Caracol42/Discrete-Circuits-Amplifier-Project/Documents/Proyectodocumentationv1/Proyectdocumentation.pdf

# Discrete Electronics Project: Class AB Audio Amplifier Design and Simulation Report

María Fernanda Morales Calderón, Ian José Álvarez Arrieta, Oscar Felipe Montejo Cordero, Bryan Alessandro Elizondo Fallas, Andrés Obregón López
School of Electronics Engineering Tecnológico de Costa Rica (TEC) Analog One

Abstract—This paper presents the design and simulation of a discrete-component Class AB audio amplifier developed by Analog One. The system combines signal conditioning, voltage amplification, and a power stage to drive an 8 Ω loudspeaker. The design uses commercial component values and considers signal quality, transistor bias, and heat dissipation. The main calculations establish a 20W output reference. In the recorded reference test, a 20 V peak input at 10 kHz produced 22.8W of average load power. Calculated requirements and simulation readings are presented in separate tables to support a clear assessment of the design.
Index Terms—Class AB, audio amplifier, discrete circuits, MOSFET, circuit simulation.
I. PROJECT DESCRIPTION

The project develops an audio amplifier that increases the level of an incoming audio signal and supplies the power needed by an 8 Ω loudspeaker. Developed by Analog One, the design aims to reproduce the signal at a useful output level while limiting distortion and power losses.
The amplifier contains three stages. The preamplifier conditions the incoming signal, the voltage amplifier increases its amplitude, and the power stage provides the current required by the loudspeaker. The Class AB output arrangement uses two complementary transistors that share the audio waveform. A small resting current helps smooth the transition between the positive and negative portions of the signal.
The design combines calculations, commercial component values, and circuit simulation. The evaluation considers output power, signal transfer, bias adjustment, and heat dissipation, together with the interaction between the stages.

II. BLOCK DIAGRAMS

A. Overall Amplifier

Figure 1 shows how the signal moves through the amplifier. Each stage has a specific role, from preparing the incoming signal to delivering power to the loudspeaker.

Preamplification
Signal
conditioning

Voltage
amplification

Class AB
power stage
Audio input | 20 V peak interface | 8 Ω loudspeaker

Figure 1. Main stages of the audio amplifier.

B. Preamplification Stage
Figure 2 shows the functional structure of the preamplification stage. The incoming signal passes through an ACcoupling network to remove any DC offset before reaching the discrete BJT amplifier. The single-ended Common-Emitter (CE) topology provides the necessary voltage amplification, while an unbypassed emitter resistor stabilizes the bias point and thermal drift. Finally, an output coupling network blocks the collector DC level, delivering a clean audio AC waveform centered at 0 V DC to the downstream mixing and power stages.

Audio Input
Coupling

BJT CE Voltage
amplification

Output DC
blocking
Audio Signal input | 2N2222 Active stage | 0 V DC interface

Figure 2. Functional blocks of the BJT preamplifier stage.

C. Voltage Amplification Stage
The voltage amplifier connects the preamplifier to the input of the power stage. Figure 3 follows the signal from left to right. Each IRF530 inverts the signal at its drain, so the two stages together preserve the input polarity near midband. The IRF9540 supplies current to the second stage.

Input coupling
C1

First gain
Q4

Second gain
Q1 with Q2

Output through C4

Figure 3. Signal path through the voltage amplification stage.

D. Class AB Power Stage
The Class AB arrangement was selected because it combines a smooth transition between the two portions of an audio signal with moderate resting power consumption. Its overlapping conduction helps reduce crossover distortion, which is particularly relevant when reproducing small changes in the waveform [1, sec. 7–2].
The selected circuit also provides the current needed by the loudspeaker while preserving the signal polarity and most of its voltage amplitude. These features make it suitable as the final stage of an amplifier whose preceding stages already provide the required voltage level [1, sec. 9–2].

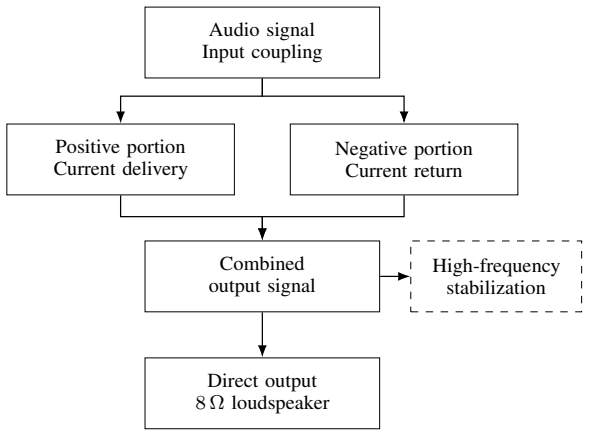
[picture p9: figure]
Audio signal Input coupling; Positive portion Current delivery; Negative portion Current return; Combined output signal; Direct output 8 Ω loudspeaker; High-frequency stabilization

Figure 4. Functional blocks of the selected Class AB output arrangement.

III. DESIGN CONSIDERATIONS AND CALCULATED VALUES

A. Preamplification Stage
The preamplifier uses a 2N2222 NPN BJT in a Common-Emitter (CE) configuration powered by a single positive supply VCC = 24 V (or +12 V single rail domain). Figure ?? presents the complete schematic diagram of the stage. The design uses an unbypassed emitter resistor R4 to fix the AC voltage gain independently of transistor parameter variations (β) and to minimize thermal drift.


Figure 5. Preamplifier schematic stage featuring 2N2222 BJT.

1) DC Operating Point Analysis: The DC bias network is established by the base voltage divider R1 and R2, collector resistor R3, and emitter resistor R4. Coupling capacitors C1 and C2 act as open circuits for DC.

The base Thévenin equivalent resistance RT h and voltage VT h are:

RT h = R1 ∥ R2 =

(68 kΩ)(33 kΩ)
68 kΩ + 33 kΩ

≈ 22.22 kΩ (1)

VT h = VCC (︃
R2
R1 + R2

)︃
= 24 V

(︃
33 kΩ
68 kΩ + 33 kΩ

)︃
≈ 7.84 V
| (2)
Assuming VBE = 0.7 V and a nominal current gain β = 150, the base bias current IBQ is:

IBQ =

VT h − VBE
RT h + (β + 1)R4

=

7.84 V − 0.7 V
22.22 kΩ + (151)(2.2 kΩ) ≈ 20.14 µA
| (3)
The quiescent collector current ICQ and emitter current IEQ are:
ICQ = βIBQ = (150)(20.14 µA) ≈ 3.02 mA | (4)
IEQ = (β + 1)IBQ ≈ 3.04 mA | (5)

The resulting DC voltages at the emitter (VE), collector (VC ), and collector-to-emitter (VCEQ) are calculated as:

VE = IEQR4 = (3.04 mA)(2.2 kΩ) ≈ 6.69 V (6)

VC = VCC −ICQR3 = 24 V−(3.02 mA)(4.7 kΩ) ≈ 9.81 V
| (7)
VCEQ = VC − VE = 9.81 V − 6.69 V = 3.12 V | (8)

The Q-point (VCEQ, ICQ) = (3.12 V, 3.02 mA) ensures stable operation within the linear active region.
2) Small-Signal AC Voltage Gain: The dynamic emitter resistance re at room temperature (VT ≈ 25.85 mV) is:

rre =

VT

ICQ

=

25.85 mV
3.02 mA
≈ 8.56 Ω | (9)

Because the emitter resistor R4 is fully unbypassed to control gain and prevent distortion/clipping, the small-signal voltage gain Av of the stage is given by:

Av =

vout

vin

≈ −

R3 ∥ RL
re + R4

≈ −

4.7 kΩ
8.56 Ω + 2.2 kΩ

≈ −2.13 V/V

| (10)
3) Thermal and Power Dissipation Analysis: At ambient temperature TA = 25◦C, the quiescent power dissipation of the transistor Q1 is:

PD,Q1 = VCEQICQ = (3.12 V)(3.02 mA) ≈ 9.42 mW
| (11)
Using the junction-to-ambient thermal resistance θJA = 200◦C/W for the TO-92 package, the operating junction temperature TJ is:

TJ = TA+PD,Q1θJA = 25◦C+(0.00942 W)(200◦C/W) ≈ 26.88◦C
| (12)
This negligible temperature rise (∆T ≈ 1.88◦C) confirms that
no external heat sink is required.

Table I
CALCULATED PREAMPLIFIER BIAS AND PERFORMANCE PARAMETERS
Parameter | Calculated Value
Base Voltage (VB) | 7.39 V
Emitter Voltage (VE) | 6.69 V
Collector Voltage (VC ) | 9.81 V
Quiescent Current (ICQ) | 3.02 mA
Collector-Emitter Voltage (VCEQ) | 3.12 V
Stage AC Voltage Gain (Av) | −2.13 V/V
Transistor Power Dissipation (PD,Q1) | 9.42 mW
Estimated Junction Temp. (TJ ) | 26.88◦C
B. Voltage Amplification Stage
Figure 6 shows the Multisim circuit used for the final test. The design target was a 20 V peak sine wave at the power-stage input from a 2 V RMS signal, using ±24 V supplies. The corresponding output voltage and required gain are

Vout,rms = 20/

√
2 = 14.14 V, | (13)
Av,target = 14.14/2 = 7.07 V/V. | (14)


Figure 6. Voltage amplification stage as tested in Multisim. VC4 is the common drain node before the output capacitor. The 43 kΩ resistor represents the load used for this stage test.

1) DC operating point: At zero input, C1 isolates the gate of Q4 from the source. Neglecting gate current, its bias divider gives
VG4 = 24 V 100
240 + 100
= 7.06 V, | (15)
RS4 = R5 + R6 = 2.09 kΩ. | (16)

Using the simulated Q4 drain level of 16.89 V and the 4.7 kΩ drain resistor, the first-stage bias can be reconstructed without assuming a fixed MOSFET threshold:

ID4 = (24 − 16.89) V/R1 = 1.51 mA, | (17)
VS4 = ID4RS4 = 3.16 V, | (18)
VGS4 = 7.06 − 3.16 = 3.90 V, | (19)
VDS4 = 16.89 − 3.16 = 13.73 V. | (20)

For Q2, the 1.0 kΩ and 5.3 kΩ divider sets the gate voltage to 24(5.3/6.3) = 20.19 V. In the second stage, R13 feeds the drain voltage back to the gate of Q1, and R9 returns the gate to −24 V. With the simulated resting voltage VX = −0.125 V at VC4, and negligible gate current, the DC path gives

Ifb = (VX + 24 V)/(R13 + R9) = 0.715 mA, | (21)
VG1 = −24 V + IfbR9 = −19.78 V. | (22)

This places the internal output close to the midpoint of the supplies. A 20 V excursion about that point leaves approximately 4 V to each rail, before allowing for voltage drops in the devices and source resistors.

2) Signal coupling and power: The input resistance set by the gate divider is R2 ∥ R4 = 70.6 kΩ. With the ideal test source, the input coupling corner is 1/(2πC1(R2 ∥ R4)) = 2.25 Hz. At the output, C4 blocks the internal DC level while R3 returns Vout to ground. At the target amplitude the load draws 14.14 V/43 kΩ = 0.329 mA RMS and dissipates 14.14²/43000 = 4.65 mW.

At rest, Q4 dissipates approximately VDS4ID4 = 20.8 mW. The Q2 gate divider draws 24 V/(6.3 kΩ) = 3.81 mA. Its resistor losses, calculated as I

2R, are 14.5 mW in R11 and 76.9 mW in R14.

For an estimate of the second-stage resting losses, take VGS1 ≈ 3.91 V, based on the observed gate-to-source voltage. Then VS1 ≈ −23.69 V and ID1 ≈ (VS1 + 24 V)/R8 = 3.07 mA. The active load supplies both this current and the feedback current, giving IQ2 ≈ 3.79 mA and VS2 ≈ 24 V − IQ2R10 = 23.62 V. Multiplying each drain-to-source voltage magnitude by its estimated current gives approximately 72 mW for Q1 and 90 mW for Q2. These are nominal bias estimates, distinct from the losses under signal drive.

C. Class AB Power Stage

Figure 7 presents the power-stage circuit. The design retains the complementary output arrangement, with nominal supplies of +24 V and −24 V. The load is connected directly to VOUT, the junction between RS1 and RS2.


Figure 7. Class AB power-stage schematic with IRFZ44N and IRF4905 MOSFETs.

1) Output Power Requirement: The design reference is 20W delivered to an 8 Ω load. For a sinusoidal signal, the average power is

PL =

V

2
L,rms
RL
. | (23)

Here, RMS is the effective voltage value used to calculate average audio power. The required load voltage and current are

VLOAD,rms =

√︁
(20)(8) ≈ 12.65 V, | (24)

VLOAD,peak =

√
2(12.65) ≈ 17.89 V, | (25)

ILOAD,rms =

12.65
8
≈ 1.58 A. | (26)

These values define the load requirements. With the specified 20 V peak input, the output power depends on the voltage transfer of the stage. Table II summarizes the calculated values.

Table II
CALCULATED OUTPUT REQUIREMENTS FOR THE 20W REFERENCE
Quantity | Calculated value
Average output power, reference | 20W
Load RMS voltage | 12.65 V
Load peak voltage | 17.89 V
Load peak-to-peak voltage | 35.78 V
Load RMS current | 1.58 A
Load peak current | 2.24 A
2) Class AB Bias Adjustment: Bias sets the transistor operating conditions before an audio signal is applied. The design adopts a quiescent drain-current target of IDQ = 50 mA in each branch. This small resting current provides the intended overlap between the two transistors near the signal transition [1, sec. 7–2].
The 0.22 Ω source resistors provide a convenient current reference. At the selected target, the drop across each resistor is
VRS,Q = IDQRS = (0.050)(0.22) = 11 mV. (27)

Bias adjustment targets these drops while keeping VOUT close to 0 V DC. Because SPK2 is connected directly to this node, the same DC voltage appears across the load.
The updated component labels give the effective bias resistances
RN = R2 + R1eff, | (28)
RP = R5 + R6eff. | (29)

The nominal gate voltages follow the two dividers:

VG,U1 = 24 V R3
RN + R3
, | (30)
VG,U2 = −24 V | R4
RP + R4
. | (31)

With R3 = R4 = 100 kΩ, the initial gate references of +3.6243 V and −3.6123 V correspond to RN = 562.2 kΩ and RP = 564.4 kΩ. Commercial 560 kΩ resistors R2 and R5 are combined with 10 kΩ trimmers R1 and R6. Their nominal effective settings are 2.2 kΩ and 4.4 kΩ, respectively, or 22% and 44% of the trimmer range.
These divider settings provide the initial gate voltages. The 50 mA target is assessed through the separate DC operatingpoint analysis and the drops in (27).

Table III
CALCULATED BIAS REFERENCES AND ADJUSTMENT TARGETS
Quantity | Design reference
U1 gate bias, initial | +3.6243 V
U2 gate bias, initial | −3.6123 V
RN = R2 + R1eff | 562.2 kΩ
RP = R5 + R6eff | 564.4 kΩ
R1 effective setting | 2.2 kΩ
R6 effective setting | 4.4 kΩ
IDQ, target per MOSFET | 50 mA
RS1 and RS2 drop at target | 11 mV each
VOUT at rest, target | 0 V DC
3) Signal Coupling: C1 and C2 transfer the audio signal to the gates while keeping their DC bias settings separate from the preceding stage. Each capacitor is 4.7 µF. With a lowimpedance driving source, the divider resistance seen by each capacitor is approximately 84.9 kΩ, giving an input coupling corner near 0.40 Hz. C1 and C2 are polarized electrolytics. With zero DC at VIN, the positive terminal of C1 faces the upper bias node, while the positive terminal of C2 faces VIN. The output is connected directly to the 8 Ω load. RZobel1 and C3 form the series output RC network, with values of 10 Ω and 100 nF. This branch provides a high-frequency load in parallel with the loudspeaker.

4) Heat Dissipation: All thermal calculations use an ambient temperature of TA = 25 ◦C, both at rest and during signal operation. The analysis relates each component’s power loss to its estimated steady-state temperature. Table IV summarizes the results and the thermal-resistance parameters used in the calculation.
Power losses: At IDQ = 50 mA, the resting losses in each MOSFET and source resistor are
PD,Q = (24 − IDQRS)IDQ ≃ 1.20W, | (32)
PRS,Q = I

2
DQRS = 0.55 mW. | (33)

Resistor losses follow PR = I

2
rmsR. For example, the recorded gate RMS voltage gives

PR3 = PR4 =

14.6

2
100000
= 2.13 mW. | (34)

The same calculation gives 1.09 mW in R2 and 1.08 mW in R5. R1 and R6 dissipate 4.28 µW and 8.50 µW, respectively. For the gate-resistor loss calculation, the estimated RMS currents are 1.306 mA and 3.022 mA:

PRG1 = (1.306 × 10⁻³
)

2
(100) ≃ 0.171 mW, (35)
PRG2 = (3.022 × 10⁻³
)

2
(100) ≃ 0.913 mW. | (36)
Capacitor losses follow PC | = I

2
C,rmsrESR, where ESR
represents the capacitor’s series loss resistance. Using a fixed ESR of 34 Ω and estimated currents of 1.317 mA and 3.026 mA gives

PC1 = (1.317 × 10⁻³
)

2
(34) ≃ 0.0590 mW, (37)
PC2 = (3.026 × 10⁻³
)

2
(34) ≃ 0.311 mW. (38)

These gate and input-capacitor currents are calculated with a constant input-capacitance approximation for the MOSFETs. At 10 kHz, the C3 loss calculation uses tan δ = 0.025:

XC3 =

1
2πfC3
= 159.15 Ω, | (39)
rESR,3 = tan δ XC3 = 3.98 Ω. | (40)

The Zobel-branch current is

IZ =

13.5
√︁
(10 + 3.98)² + 159.15²

≃ 84.50 mA. (41)

Therefore,

PRZobel1 = I

2
Z(10) ≃ 0.0714W, | (42)
PC3 = I

2
ZrESR,3 ≃ 0.0284W. | (43)

The source-resistor sizing calculation includes the load current, the Zobel-branch current, and IDQ:

PRS,design = 0.22(1.69 + 0.0845 + 0.050)² ≃ 0.732W. (44)

This power allowance applies to each 5W source resistor. Component temperatures: The passive-component temperature calculation is

Ti = TA + RθiPi

. | (45)

For example,

TRS1 = TRS2 ≃ 25 + (0.732)(55) = 65.3

◦C, | (46)

TC3 ≃ 25 + (0.0284)(1157) = 57.9

◦C. (47)

The same expression is applied to the remaining passive components using the power and thermal resistance listed in Table IV.
For the MOSFETs, the calculation includes a separate 4

◦C/W heat sink for each device and a 0.5

◦C/W mounting
interface:

TJ = TA + PD(RθJC + RθCS + RθSA). (48)

The datasheet junction-to-case thermal resistances are 1.5

◦C/W for U1 and 0.75 ◦C/W for U2 [2], [3]. Using the recorded transistor losses gives

TJ,U1 = 25 + 6.58(1.5 + 0.5 + 4) ≃ 64.5

◦C, (49)

TJ,U2 = 25 + 6.63(0.75 + 0.5 + 4) ≃ 59.8

◦C. (50)

At rest, the calculated junction temperatures are 32.2

◦C for U1
and 31.3

◦C for U2. At the 10W per-device design allowance, they are 85 ◦C and 77.5

◦C, below the selected 100 ◦C design limit.

Table IV
CALCULATED COMPONENT TEMPERATURES AT 25 ◦C
Component | Power used | Rθ (
| | ◦C/W) | Temperature (◦C)
U1 | 6.58W | 6.00 | 64.5
U2 | 6.63W | 5.25 | 59.8
R1 | 4.28 µW | 263 | 25.0
R2 | 1.09 mW | 140 | 25.2
R3, R4 | 2.13 mW each | 140 | 25.3 each
R5 | 1.08 mW | 140 | 25.2
R6 | 8.50 µW | 263 | 25.0
RG1 | 0.171 mW | 140 | 25.0
RG2 | 0.913 mW | 140 | 25.1
RS1, RS2 | 0.732W each | ≃ 55 | 65.3 each
RZobel1 | 0.0714W | 75 | 30.4
C1 | 0.0590 mW | 472 | 25.0
C2 | 0.311 mW | 472 | 25.1
C3 | 0.0284W | 1157 | 57.9

Temperatures are steady-state analytical estimates at 25 ◦C, rounded to 0.1

| | | ◦C. U1/U2
entries are junction temperatures; passive entries are body temperatures. The Rθ column lists the calculation parameters. RS1/RS2 use a power allowance for component sizing. Gate and capacitor losses are analytical estimates.

IV. COMPONENT SELECTION CRITERIA

A. Preamplification Stage
The selection of passive and active components for the preamplifier focuses on signal integrity, gain stability, and minimal noise introduction. Table V summarizes the chosen components and their design specifications.
- Transistor (Q1): The 2N2222 general-purpose NPN transistor was chosen due to its wide linear operational range, high gain-bandwidth product (fT > 250 MHz), and ready availability in TO-92 packages.
- Emitter Resistor (R4): Left unbypassed to introduce negative local feedback. This lowers non-linear distortion

Table V
PREAMPLIFIER COMPONENTS AND SELECTION RATINGS
Reference | Nominal Value | Selection Rating / Purpose
Q1 | 2N2222 | NPN BJT, general-purpose switching/amp
R1 | 68 kΩ | Metal film, 1%, 0.25 W (Upper Bias)
R2 | 33 kΩ | Metal film, 1%, 0.25 W (Lower Bias)
R3 | 4.7 kΩ | Metal film, 1%, 0.25 W (Collector Load)
R4 | 2.2 kΩ | Metal film, 1%, 0.25 W (Feedback Emitter)
R5 | 100 kΩ | Metal film, 1%, 0.25 W (Output Pull-down)
C1 | 470 nF | Film/Ceramic, 50 V (Input AC Coupling)
C2 | 2.2 µF | Electrolytic/Film, 50 V (Output DC Block)
C3 | 1 nF | Ceramic, 50 V (High-Freq Noise Filtering)

and prevents gain drift caused by temperature or β variations.
- Coupling Capacitors (C1, C2): Sized to maintain a lower cutoff corner frequency well below the audible spectrum (fL < 20 Hz), preventing baseline attenuation of lowfrequency audio content.
- Output Pull-down (R5): Provides a continuous reference to ground at the output side of C2, guaranteeing a zero DC baseline before entering the operational amplifier mixing stage.
B. Voltage Amplification Stage

Two IRF530 N-channel MOSFETs [4] were selected for voltage gain and an IRF9540 P-channel MOSFET [5] for the active load. Its maximum drain-to-source voltage is −100 V. Both models were available in the Multisim library and listed by the local supplier reviewed for the project. The source resistors provide local feedback. The values of the input and feedback resistors were tested together because they affect both the gain of Q1 and the load seen by Q4.

Table VI
VOLTAGE-STAGE COMPONENT VALUES USED IN THE FINAL SIMULATION.
Reference Value | Function
Q4, Q1 | IRF530 | Common-source gain
Q2 | IRF9540 | Active load
R2, R4 | 240, 100 kΩ | Q4 gate bias
R1 | 4.7 kΩ | Q4 drain load
R5, R6 | 1.27 kΩ, 820 Ω Q4 source path
R12, R13 | 3.48, 27.5 kΩ | Input and feedback
R9 | 5.9 kΩ | Return to −24 V
R8, R10 | 100 Ω each | Source resistors
R11, R14 | 1, 5.3 kΩ | Q2 gate bias
R3 | 43 kΩ | Output test load
C1 | 1 µF | Nonpolar input coupling
C3, C4 | 4.7 µF each | Interstage and output
C. Class AB Power Stage

The selected components retain the circuit topology and use commercial nominal values. Table VII lists the main components and the ratings considered in their selection.

Table VII
POWER-STAGE COMPONENTS AND SELECTION RATINGS
Reference | Value or model | Selection rating
U1 | IRFZ44N | N-channel MOSFET
U2 | IRF4905 | P-channel MOSFET
R2, R5 | 560 kΩ | 1%, 0.25W
R3, R4 | 100 kΩ | 1%, 0.25W
R1, R6 | 10 kΩ | Trimmers, 0.25W
RG1, RG2 | 100 Ω | 0.25W
RS1, RS2 | 0.22 Ω | 5W
C1, C2 | 4.7 µF | 50 V, electrolytic
RZobel1 | 10 Ω | 2W
C3 | 100 nF | 50 V, ceramic, code 104
SPK2 | 8 Ω | 30W nominal rating

The MOSFET voltage ratings are considered together with the ±24 V supplies and the expected signal excursions [2], [3]. The source-resistor power ratings provide margin for the load current, while the gate resistors and output RC network help control high-frequency behavior.
The heat-sink selection follows the stated dissipation allowance. The component references in Table VII match the updated schematic, including C1/C2 as electrolytic coupling capacitors and C3 as the 100 nF ceramic Zobel capacitor marked 104.
V. SIMULATION METHODOLOGY
A. Common Simulation Conditions
Multisim provides the circuit environment for the reported test. The power-stage input is a 20 V peak sinusoidal signal at 10 kHz, with zero DC offset. The circuit uses nominal ±24 V supplies and an 8 Ω load. R1 and R6 have nominal settings of 22% and 44%, respectively. These settings establish the initial divider voltages; the DC analysis assesses IDQ separately.
B. Preamplification Stage
The simulation of the BJT preamplifier stage was conducted in both LTspice and NI Multisim to verify DC biasing, dynamic transient behavior, and overall voltage amplification before physical assembly.
1) DC Operating Point Analysis: The simulation evaluates the circuit under zero-input signal condition (vin = 0 V AC). It measures the base voltage (VB), emitter voltage (VE), collector voltage (VC ), and collector bias current (ICQ) of transistor Q1. The objective is to verify that the operating point resides in the linear active region (VCEQ ≈ 3.12 V, ICQ ≈ 3.02 mA), avoiding saturation or cutoff limits and providing adequate headroom for signal swings.
2) Transient Analysis: A 1 kHz sinusoidal voltage source (V1) was applied at the input coupling capacitor C1. Transient simulations were run with a time step sufficient to capture multiple complete audio cycles (e.g., tstop = 10 ms). The transient response measures the peak-topeak input and output voltage waveforms, evaluating the stage voltage gain Av = vout/vin and checking for asymmetrical clipping or waveform distortion caused by high signal amplitudes.
3) Frequency Response and Filtering: An AC sweep simulation (10 Hz to 100 kHz) was executed to determine the lower and upper −3 dB cutoff frequencies (fL and fH). This analysis assesses the high-pass response determined by coupling capacitors C1 and C2, as well as the high-frequency attenuation introduced by filtering capacitor C3.
C. Voltage Amplification Stage
The voltage stage was tested separately in Multisim using the 43 kΩ load in Fig. 6. First, the source amplitude was set to zero and the voltage at VC4 was recorded. Next, a 2 V RMS, 1 kHz sine wave was applied. Cursors on the output trace measured the positive and negative peaks relative to ground.
The Fourier analysis used a 1 kHz fundamental, nine harmonics and a 2 s stop time to allow the coupling capacitors to settle. Distortion was calculated from harmonic amplitudes Vn measured using the same convention:

THD2:9 = 100

√︂∑︁9
n=2 V ²
n
V1
%. | (51)

Here V1 in the equation denotes the output fundamental. A separate small-signal AC sweep measured |Vout/Vin| with a unit AC input. Output amplitude and distortion were assessed from the driven sine-wave test.

D. Class AB Power Stage
1) DC Operating Point: The DC analysis examines the circuit with no audio input. It identifies the transistor bias and the internal output voltage. The design targets are IDQ = 50 mA in each branch, 11 mV across each source resistor, and VOUT close to zero. These references define the intended Class AB resting condition.
2) Transient Response: The transient analysis follows the input and output signals over time. It provides the voltage, current, and average-power measurements reported in the results. The method compares settled signal cycles, allowing the output level and the transition between the two transistors to be examined under the same test conditions.
3) Frequency Response and Signal Quality: Frequency-response evaluation examines how the amplifier handles signals at different audio frequencies. Waveform and harmonic analyses assess changes in signal shape, including the transition between the positive and negative portions. These assessments complement the power measurements; the numerical readings presented here correspond to the documented 10 kHz test.

VI. SIMULATED VALUES AND RESULTS

A. Preamplification Stage
The preamplifier stage was simulated in NI Multisim to evaluate both the DC bias point and the transient response under real audio signal excitation.
Table VIII compares the calculated theoretical DC parameters with the values obtained from the simulation. The results show close agreement, with maximum percentage deviations below 4.3%. The simulated collector current ICQ = 1.055 mA and collector voltage VC = 19.466 V confirm that the 2N2222 transistor operates within its linear active region with sufficient voltage swing headroom. Furthermore, the simulated DC voltage at the output node (Vout,DC = 194.66 pV) confirms the effectiveness of the output coupling network (C2) in isolating the DC bias from downstream stages.

Table VIII
COMPARISON OF CALCULATED AND SIMULATED DC OPERATING PARAMETERS
Parameter | Calculated | Simulated | Deviation (%)
Base Voltage (VB) | 3.07 V | 3.03 V | 1.30%
Emitter Voltage (VE) | 2.24 V | 2.33 V | 4.02%
Collector Voltage (VC ) | 19.65 V | 19.47 V | 0.92%
Collector Current (ICQ) | 1.012 mA | 1.055 mA | 4.25%
Collector-Emitter Voltage (VCEQ) | 17.41 V | 17.14 V | 1.55%
Output DC Baseline (Vout,DC ) | 0 V | 194.66 pV | ∼ 0%

Under dynamic excitation, the output audio signal exhibits symmetric voltage excursions reaching approximately 1 Vpp (±500 mVpeak) centered at 0 V DC, demonstrating clean linear amplification without clipping or crossover distortion.

Figure 8. Simulated transient audio output signal Vout showing symmetric AC swing centered at 0 V DC.

B. Voltage Amplification Stage
The final circuit delivered +19.919 V and −20.056 V at the output (Fig. 9). Their difference is 39.975 V peak to peak, within 0.07% of the 40 V peak-to-peak target. The resulting gain from the time-domain extrema is

Av =

39.975
2

√
2 (2)
= 7.07 V/V. | (52)

The fundamental corresponds to 20.112/

√
| 2 = 14.22 V
RMS. Its peak amplitude differs slightly from either oscilloscope cursor because the waveform also contains harmonics.
C. Class AB Power Stage

Tables X and XI retain the available 10 kHz reference readings for comparison and thermal calculations. The updated schematic defines a single output node shared by the source-resistor junction and SPK2. RMS describes the effective signal level, peak-to-peak describes the full voltage or current swing,


Figure 9. Multisim test at 2 V RMS and 1 kHz. Channel A (red) shows Vout. The cursors mark opposite peaks.

Table IX
FINAL VOLTAGE-STAGE RESULTS WITH THE 43 kΩ LOAD.
Quantity | Simulation result
Internal output at rest (VC4) | −0.125 V
Output DC, Fourier record | 0.996 mV
Output fundamental at 1 kHz | 20.112 V peak
Second / third harmonic | 0.077/0.193 V peak
THD through the ninth harmonic 1.183%
Small-signal gain near 20 Hz | 6.930 V/V
Small-signal gain near 1 kHz | 7.118 V/V

and mean describes the average DC component. The power readings are average values over the measurement interval.

Table X
RECORDED VOLTAGE REFERENCES AT 10 kHz
Location | Peak-to-peak RMS | Mean
IRFZ44N gate | 39.9 V | 14.6 V | +3.62 V
IRF4905 gate | 39.8 V | 14.6 V | −3.62 V
Output AC reference | 38.2 V | 13.5 V | —

The output reference is 13.5 V RMS. The dash indicates that a DC measurement for the revised VOUT connection is not included in these reference readings. Its DC adjustment target is 0 V. The gate means describe signal-on operation; IDQ is assessed with the input amplitude set to zero.

Table XI
RECORDED CURRENT AND POWER REFERENCES AT 10 kHz
Quantity | Simulated value
Load-current peak-to-peak | 4.78 A
Load-current RMS | 1.69 A
Average loudspeaker-load power | 22.8W
IRFZ44N average dissipation | 6.58W
IRF4905 average dissipation | 6.63W
Signal frequency | 10.0 kHz

The reference output-power reading exceeds the 20W design reference. The transistor dissipation values describe heat produced within the output devices and are accounted for separately from the power received by the load.

VII. ANALYSIS AND INTEGRATION

A. Preamplification Stage
The calculated small-signal gain Av ≈ −2.13 V/V provides moderate, highly controlled amplification without driving the output into saturation or cut-off under standard audio linelevel inputs. By setting the quiescent collector voltage VC to approximately 9.81 V, the collector node retains ample headroom for positive and negative voltage swings.
When integrated into the complete audio system, the preamplifier’s output node connects via C2 to the input resistor of the TL081-based summer/inverting stage (R11 = 2.2 kΩ). The output coupling network (C2 and R5) successfully eliminates the +9.81 V DC offset from the colector of Q1, ensuring the TL081 receiving terminal operates centered at 0 V DC. Furthermore, the unbypassed topology eliminates clipping at the peak excursions, matching the downstream headroom requirements of the Class AB output driver stage.
B. Voltage Amplification Stage

The resistor changes were evaluated at comparable output levels. At 1 kHz, one intermediate network produced 15.2 V RMS with 4.87% THD. A lower-resistance network produced 15.1 V RMS with 2.85% THD. In the final network, increasing R12 from 3.3 to 3.48 kΩ brought the measured swing from 40.80 to 39.98 V peak to peak and reduced THD from 1.37% to 1.18%. The final choice therefore reflects both the voltage required at the interface and the shape of the signal.
The standalone test establishes the voltage available to drive the next block. The 43 kΩ load draws a fraction of a milliampere, whereas the Class AB stage supplies the loudspeaker current. When the stages are connected, the input bias network of the power stage becomes an additional load. The corresponding interface check is to measure the voltage at the power-stage input under that load.
C. Class AB Power Stage

The recorded reference output voltage supports the average-power result. Applying (23) gives

PL =

(13.5)²
8
= 22.78W, | (53)

which agrees with the 22.8W simulation reading after rounding. The expected current is 13.5/8 = 1.69 A RMS, also consistent with the recorded value.
The 38.2 V peak-to-peak output corresponds to approximately 19.1 V peak. Compared with the specified 20 V peak input, the output amplitude is 95.5% of the input amplitude. This small reduction is consistent with the power stage’s role of supplying current while preserving the signal polarity and most of its voltage amplitude.
In the recorded reference test, the delivered power is 14% above the 20W objective. This result provides the comparison baseline for the updated power-stage schematic. The two transistor losses are similar, and both remain below the 10W per-device thermal design allowance.
For integration with the complete amplifier, the preceding stage provides the required input amplitude while driving the power-stage input. The bias references describe the resting condition, while the reported voltage, current, and power values describe operation with the audio test signal applied.

VIII. CONCLUSIONS AND NEXT STEPS

A. Preamplification Stage
The discrete 2N2222 BJT preamplifier stage was successfully designed and mathematically verified. By employing an unbypassed emitter topology, the stage achieves stable AC voltage gain while preserving signal linearity and preventing clipping. The DC bias point (VCEQ = 3.12 V, ICQ = 3.02 mA) ensures linear active operation, with a negligible thermal dissipation of 9.42 mW that keeps operating temperatures near 26.88◦C. Next Steps:
- Perform transient sweep simulations in LTspice/Multisim to confirm dynamic AC parameters, frequency response, and Total Harmonic Distortion (THD).
- Verify experimental integration with the TL081 mixing stage to adjust overall systemic gains.
- Validate physical breadboard performance against calculated bias points.
B. Voltage Amplification Stage
At 1 kHz the simulated voltage stage converted a 2 V RMS input into a 39.975 V peak-to-peak output across 43 kΩ. The two measured peaks were within 0.1 V of the nominal ±20 V interface level, with 1.18% THD. For the prototype, the first checks are the resting voltage at VC4 and the output swing with the power-stage input connected. Comparing those readings with the standalone results will show the effects of loading and device variation.
C. Class AB Power Stage
The complementary IRFZ44N/IRF4905 stage retains the Class AB topology and uses commercial component values. Its bias design includes a IDQ = 50 mA resting-current target, with trimmers for adjustment and source resistors that provide current references. C1 and C2 couple the input signal to the transistor gates, while the load connects directly to VOUT. The thermal assessment covers transistor, resistor, and capacitor losses and gives calculated temperature estimates for the stage electronics.
With a 20 V peak input at 10 kHz, the recorded reference test delivered 22.8W to an 8 Ω load, exceeding the 20W design reference. The output reaches 13.5 V RMS and 1.69 A RMS. These reference results support the power-delivery objective for the documented test. The updated DC assessment uses the direct output connection and the 50 mA adjustment target. The thermal calculation gives MOSFET junction temperatures of 64.5

◦C and 59.8

◦C. Frequency-response, signal-quality, and connected-stage assessments complete the evaluation framework for the amplifier.

REFERENCES

[1] T. L. Floyd, Dispositivos electrónicos, 8th ed. Mexico: Pearson Educación, 2008, secs. 7–2 and 9–2.
[2] International Rectifier, “IRFZ44NPbF: HEXFET power MOSFET,” datasheet, document PD-94787B, pp. 1–4.
[3] Infineon Technologies, “IRF4905PbF: HEXFET power MOSFET,” datasheet, rev. 2.1, Apr. 8, 2026, pp. 1–4.
[4] ON Semiconductor, “IRF530: TMOS E-FET Power Field Effect Transistor,” datasheet, publication IRF530/D, rev. 2, Aug. 2006.
[5] Vishay Siliconix, “IRF9540 Power MOSFET,” datasheet, document 91078, rev. C, Aug. 16, 2021. https://www.vishay.com/docs/91078/91078.pdf.
