Caracol42/Discrete-Circuits-Amplifier-Project/Documents/fig/pot20w(3).pdf

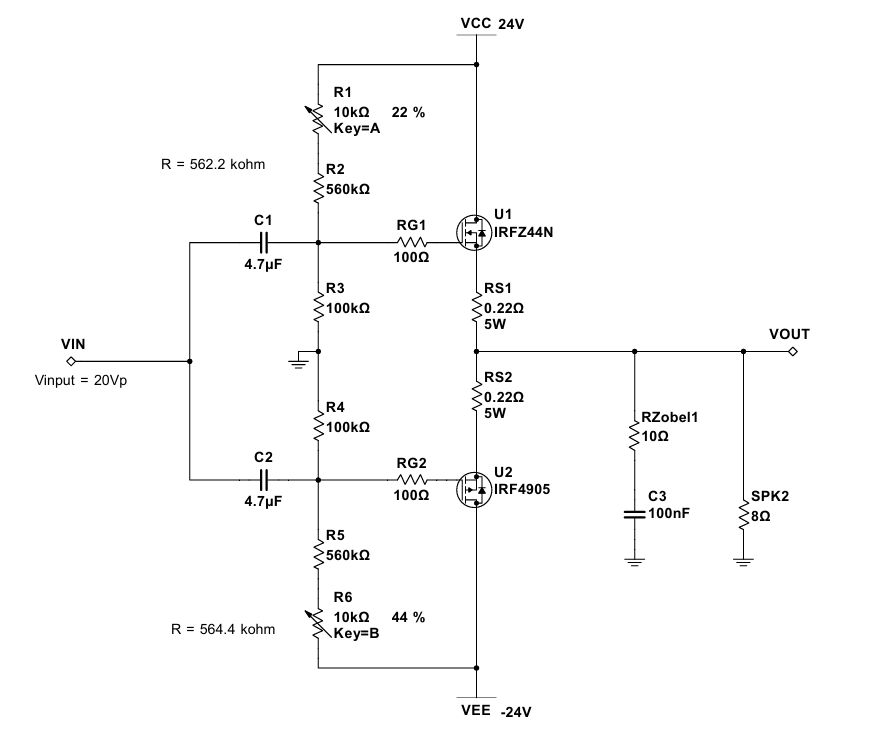
[picture p10: page 1]
