Caracol42/Discrete-Circuits-Amplifier-Project/Week 1 - V1/Leader/CRONOGRAMA.png

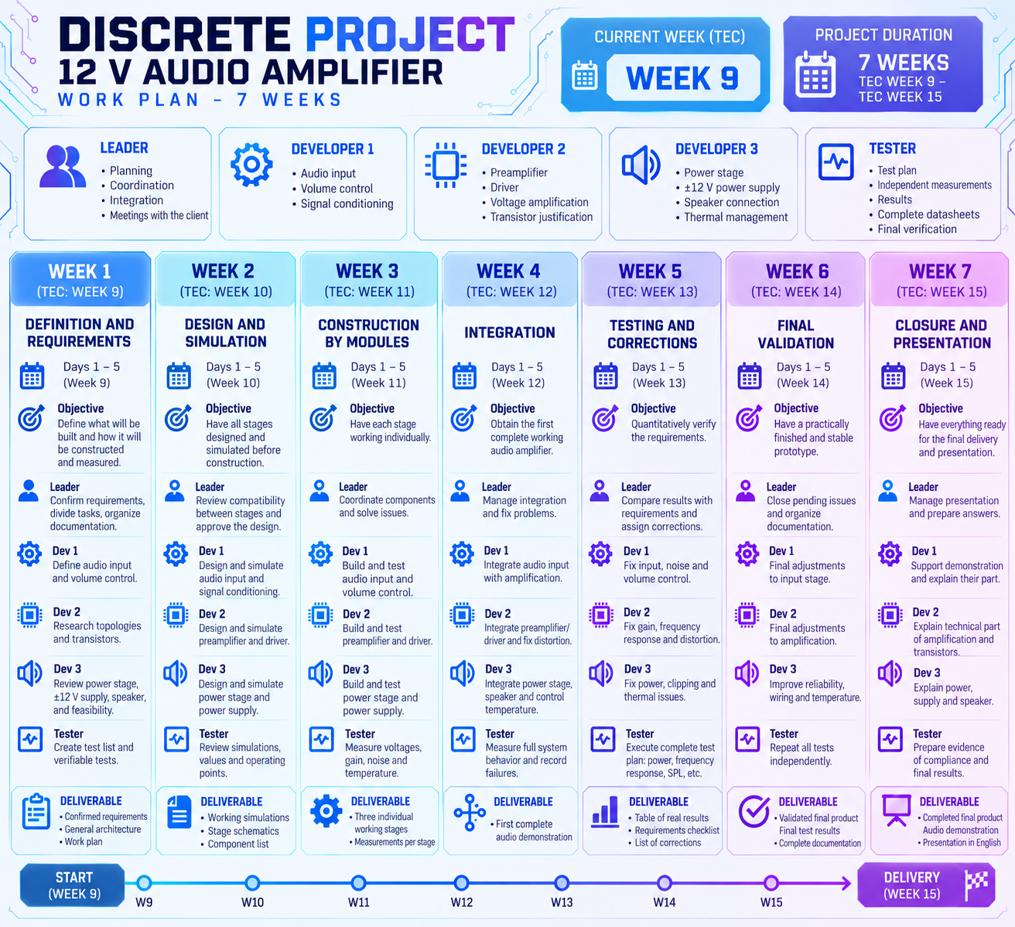
Week 1 - V1/Leader/CRONOGRAMA.png
