Caracol42/Discrete-Circuits-Amplifier-Project/Week 3 - Integration/Leader/Cronograma 2 - copia.png

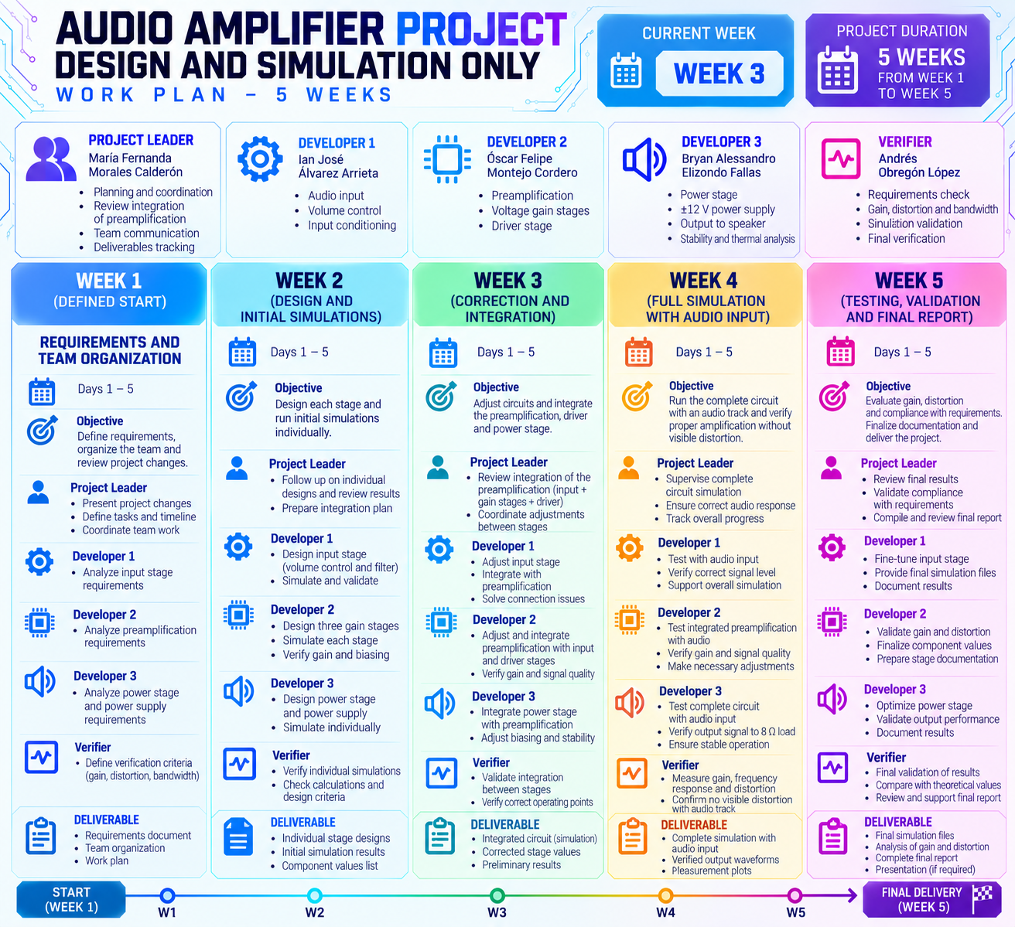
Week 3 - Integration/Leader/Cronograma 2 - copia.png
