Caracol42/Discrete-Circuits-Amplifier-Project/Week 4 - Tests/Verifier/Device Integration V1/LTSpice Simulation/AnalogOne_AMP_Circuit_Integration.asc

C1: cap; 10µ
C2: cap; 4.7µ
LOAD_SPEAKER: res; 8; pwr=20
MusicSignal: voltage; wavefile="Obsession.wav" chan=0 AC 1
NegPowerSource: voltage; -24
PosPowerSource: voltage; 24
X1: Preamplificacion_LTspice
X2: SigAmpModule_LTspice
X3: ZPowerAmpModule_LTspice
Named nets: AUX, 0, VCC, VEE, VM1, VM2, VSPK
.wave "AmpOutputMusic.wav" 16 44100 V(AUDIO_OUT)
.tran 250
Bwav AUDIO_OUT 0 V=V(VSPK)/20
