Caracol42/Discrete-Circuits-Amplifier-Project/Week 4 - Tests/Verifier/Device Integration V1/LTSpice Simulation/Preamplificacion_LTspice.asc

C1: cap; 1n
C2: cap; 10µ
C4: cap; 10µ
Q1: npn; 2N2222
R1: res; 10k
R2: res; 10k
R3: res; 100
R4: res; 100k
R5: res; 1k
R6: res; 1
R7: res; 10k
R8: res; 2.2k
R9: res; 4.3k
R10: res; 150k
R11: res; 22k
Named nets: 0, VIN, VOUT, VCC
PREAMPLIFIER MODULE V0.1
Signal AUX - JACK 3.55mm (1Vrms - 2Vrms)
Signal Output - For AMPSTAGE 2Vrms
