Caracol42/Discrete-Circuits-Amplifier-Project/Week 4 - Tests/Verifier/Device Integration V1/LTSpice Simulation/SigAmpModule_LTspice.asc

C1: cap; 4.7µ
C2: cap; 4.7µ
M1: nmos; BS170
M2: nmos; BS170
M3: pmos; IRF9510
R1: res; 330k
R2: res; 100k
R3: res; 4.7k
R4: res; 2.090k
R5: res; 53.3k
R6: res; 22k
R7: res; 100
R8: res; 220k
R9: res; 100
R10: res; 5.3k
R11: res; 1k
Named nets: VCC, 0, VIN, VEE, VOUT
Signal Amplifier Module V0.1
Signal INPUT 2Vrms
Signal OUTPUT 20Vrms
.include BS170.lib
.include IRF9510.lib
