Caracol42/Discrete-Circuits-Amplifier-Project/Week 4 - Tests/Verifier/Device Integration V1/LTSpice Simulation/ZPowerAmpModule_LTspice.asc

C1: cap; 10µ
C2: cap; 10µ
Czobel: cap; 100n
M1: nmos; IRF510
M2: pmos; IRF9510
R1: res; 100k
R2: res; 100k
R3: res; 550k
R4: res; 605k
R5: res; 100
R6: res; 100
R7: res; 0.22; pwr=5
R8: res; 0.22; pwr=5
RZobel: res; 10
Named nets: VIN, 0, VCC, VEE, VOUT
Power Amplifier Module V0.1
.include IRF9510.lib
.include IRF510.lib
