Caracol42/Discrete-Circuits-Amplifier-Project/Week 1 - V1/Developer 1 - PreAmp/PreAmplifierV1/Preamplificacion_LTspice.asc

C1: cap; 1n
C2: cap; 10µ
C4: cap; 10µ
Q1: npn; 2N2222
R1: res; 10k
R2: res; 10k
R3: res; 100
R4: res; 100k
R5: res; 1k
R8: res; 2.2k
R9: res; 4.3k
R10: res; 150k
R11: res; 22k
R12: res; 1Meg
U1: pot
V1: voltage; ""; wavefile="golden_hour.wav" chan=0 AC 1
V2: voltage; 24
Named nets: 0, out
.tran 10
.wave "amp_golden.wav" 16 48k V(out)
.include pot.sub
