Caracol42/Discrete-Circuits-Amplifier-Project/(list of files, drawings)

Other design files:
Week 1 - V1/Developer 1 - PreAmp/PreAmplifierV1/Multisim/PreAmplifier_V1.ms14
Week 1 - V1/Developer 2 - Amp/AmplifierV1/AmplifierModule_V1.ms14
Week 1 - V1/Developer 3 - PowerAmp/PowerAmp/PowerAmp_V1.ms14
Week 2 - V2/Developer 1 - PreAmp/PreAmplifierV2/Multisim/PreAmplifier_V2.ms14
Week 2 - V2/Developer 2 - Amp/AmplifierModule_V2.ms14
Week 2 - V2/Developer 3 - PowerAmp/AmpPowerFinalStage.ms14
Week 3 - Integration/Device Integration V1/MULTISIM Simulation/AnalogOne_AMP_Circuit_Integration.ms14
Week 4 - Tests/Verifier/Device Integration V1/MULTISIM Simulation/AnalogOne_AMP_Circuit_Integration.ms14
Week 5 - Device/Verifier/PrintingCircuit.ms14
Week 6 - Doc/Developer 2/Etapa_Oscar_carga_activa.ms14
