Caracol42/Discrete-Circuits-Amplifier-Project/(commit log)

2026-10-03 Project structure
    [EXCEL - AMPLIFIER PROJECT.xlsx]
2026-10-03 Developer 3 - Salida tipo A - ms14
    [Salida tipo A.ms14]
2026-10-07 Week 1 - Etapa preamplificacion
    [Etapa preamplificacion.ms14]
2026-10-16 Update project schedule and final adjustments
    [EXCEL - AMPLIFIER PROJECT.xlsx, Weekly _Excel _Adjustment1.xlsx]
2026-10-21 Parte de Oscar en el pdf
2026-11-04 Actualizar documentación del proyecto y añadir gráficos de amplificación
2026-11-04 carpeta Week 1
    [Newpowerstage20w.ms14]
2026-11-04 Organizar archivos de Week 3
    [Weekly _Excel _Adjustment1.xlsx]
2026-11-09 Organización archivos primera parte
    [EXCEL - AMPLIFIER PROJECT.xlsx, Etapa preamplificacion.ms14, Etapa_Oscar_carga_activa.ms14, Newpowerstage20w.ms14, PowerAmp20W Module v1.ms14, Salida tipo A.ms14]
2026-11-09 Documentation Week 1 - First Design
    [AmpPowerFinalStage.ms14, EXCEL - AMPLIFIER PROJECT.xlsx, Etapa preamplificacion.ms14, Etapa_Oscar_carga_activa.ms14, Newpowerstage20w.ms14, PowerAmp20W Module v1.ms14, Salida tipo A.ms14, Weekly _Excel _Adjustment1.xlsx]
2026-11-09 Ordenando archivos
    [Newpowerstage20w.ms14, Salida tipo A.ms14]
2026-11-09 parte de amplificacion Oscar
    [Etapa_Oscar_carga_activa.ms14]
2026-11-09 Actualizacion archivos de la semana 3
    [AmpPowerFinalStage.ms14, AmplifierModule_V1.ms14, Etapa preamplificacion.ms14, Etapa_Oscar_carga_activa.ms14, PowerAmp20W Module v1.ms14, PowerAmp_V1.ms14, PreAmplifier_V1.ms14, PreAmplifier_V2.ms14]
2026-11-09 Ordnando archivos
    [AmpPowerFinalStage.ms14, AmplifierModule_V2.ms14]
2026-11-09 Semanas de desarrollo ordenadas
    [AmpPowerFinalStage.ms14, AmplifierModule_V2.ms14, PreAmplifier_V2.ms14, Weekly _Excel _Adjustment1.xlsx]
2026-11-09 Integration V1 - Multisim
    [AnalogOne_AMP_Circuit_Integration.ms14]
2026-11-10 Integración V1
    [AmplifierModule_V2.ms14, AnalogOne_AMP_Circuit_Integration.ms14]
2026-11-10 Datasheet update 70%
    [PrintingCircuit.ms14]
2026-11-11 Actualizar datasheet de la etapa de amplificación
